embedded-graphics/hardware-bench/README.md

# Embedded graphics hardware test bench

Requires KiCAD 6.x.
