embedded-graphics/hardware-bench/3D/EPaper_2.13.step

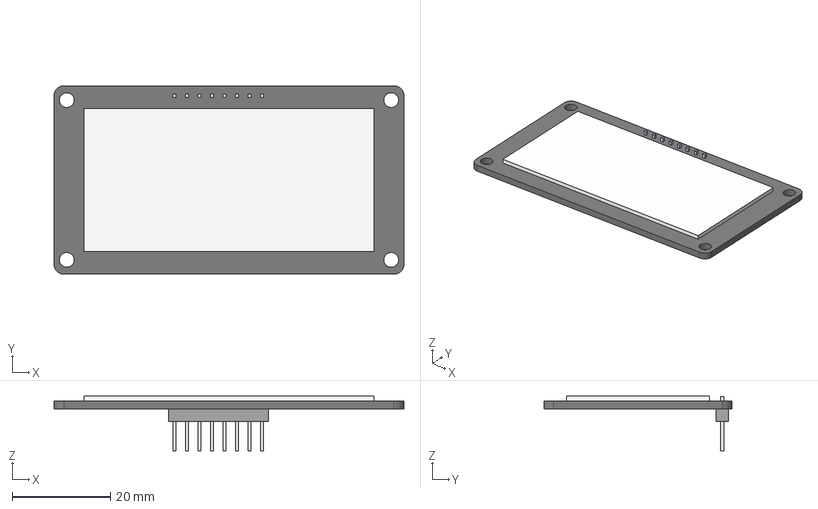
[picture p1: CAD file, 2022-11-12]
3D/EPaper_2.13.step
71.2 x 38.3 x 11.1 mm
PCB001
Pins001
EPD001
