embedded-graphics/hardware-bench/3D/OLED_0.91.step

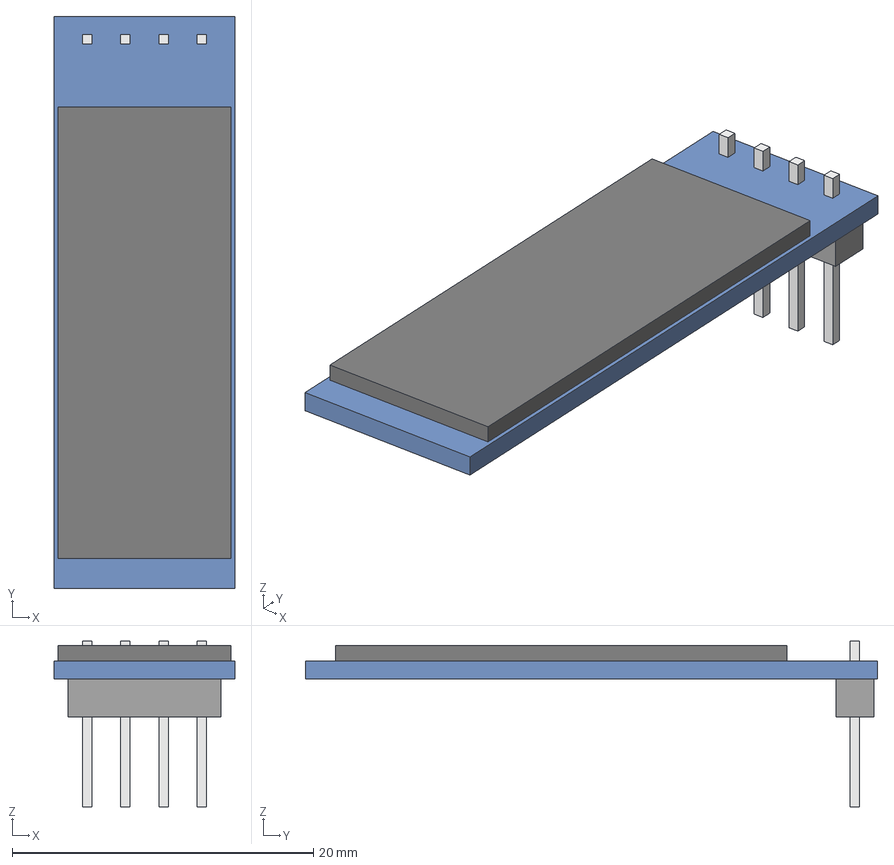
[picture p2: CAD file, 2022-11-12]
3D/OLED_0.91.step
12.0 x 38.0 x 11.0 mm
PCB
Pins
OLED
