embedded-graphics/hardware-bench/3D/RPi-Pico.step

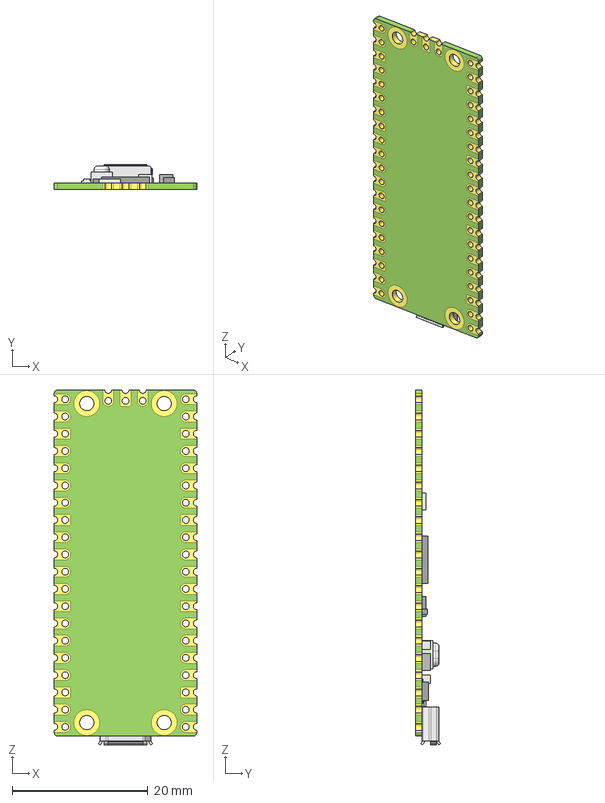
[picture p3: CAD file, 2022-11-12]
3D/RPi-Pico.step
21.0 x 3.73 x 52.3 mm
PICO_REF_BOARD.STEP
PICO_REF_USB.STEP
PICO_REF_SWITCH.STEP
PICO_REF_MICROCONTROLLER.STEP
PICO_REF_LED.STEP
PICO_REF_ONSEMI.STEP
PICO_BOURNS.STEP
PICO_MURATA.STEP x 2
PICO_RICHTEK.STEP
PICO_DIODES.STEP
PICO_AEL.STEP
PICO_WINBOND.STEP
