embedded-graphics/hardware-bench/3D/TFT_2.8_240x320.step

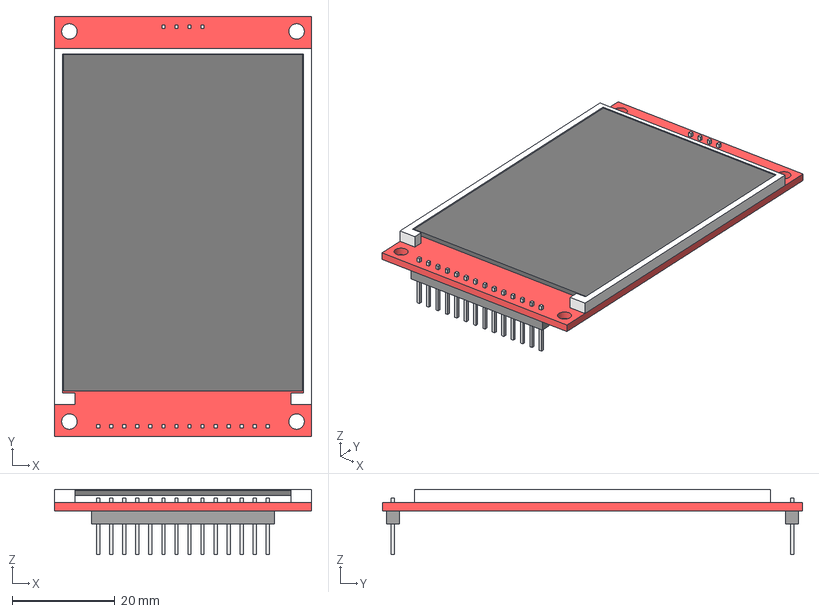
[picture p4: CAD file, 2022-11-12]
3D/TFT_2.8_240x320.step
50.0 x 81.7 x 12.7 mm
LCD
PCB
Pins Top
Pins Bottom
Frame
