embedded-graphics/hardware-bench/3D/GME12864-80.step

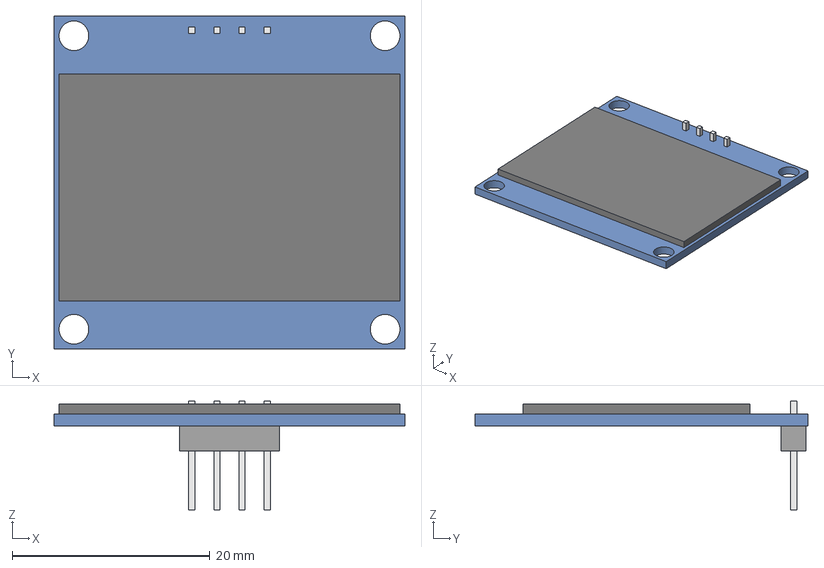
[picture p5: CAD file, 2022-11-12]
3D/GME12864-80.step
35.5 x 33.7 x 11.0 mm
OLED
PCB
Pins
