embedded-graphics/hardware-bench/3D/GME128128-02.step

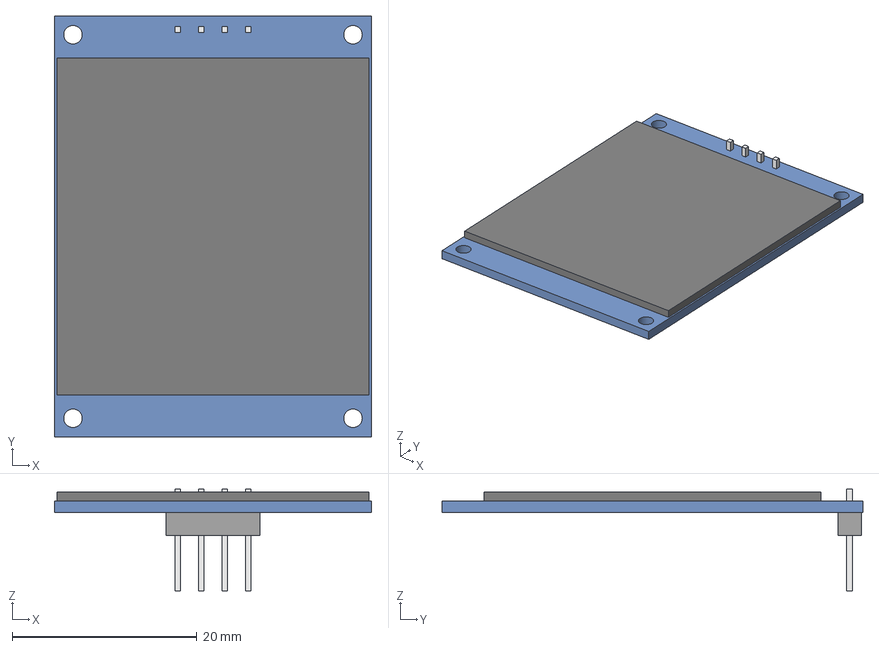
[picture p6: CAD file, 2022-11-12]
3D/GME128128-02.step
34.3 x 45.5 x 11.0 mm
OLED
PCB
Pins
