embedded-graphics/hardware-bench/(list of files, cad)

Other CAD files:
3D/EPaper_2.13.FCStd
3D/GME128128-02.FCStd
3D/GME12864-80.FCStd
3D/OLED_0.91.FCStd
3D/TFT_2.8_240x320.FCStd
