embedded-graphics/hardware-bench/hardware-bench.kicad_pcb

## KiCad design hardware-bench.kicad_pcb (2022-11-12)

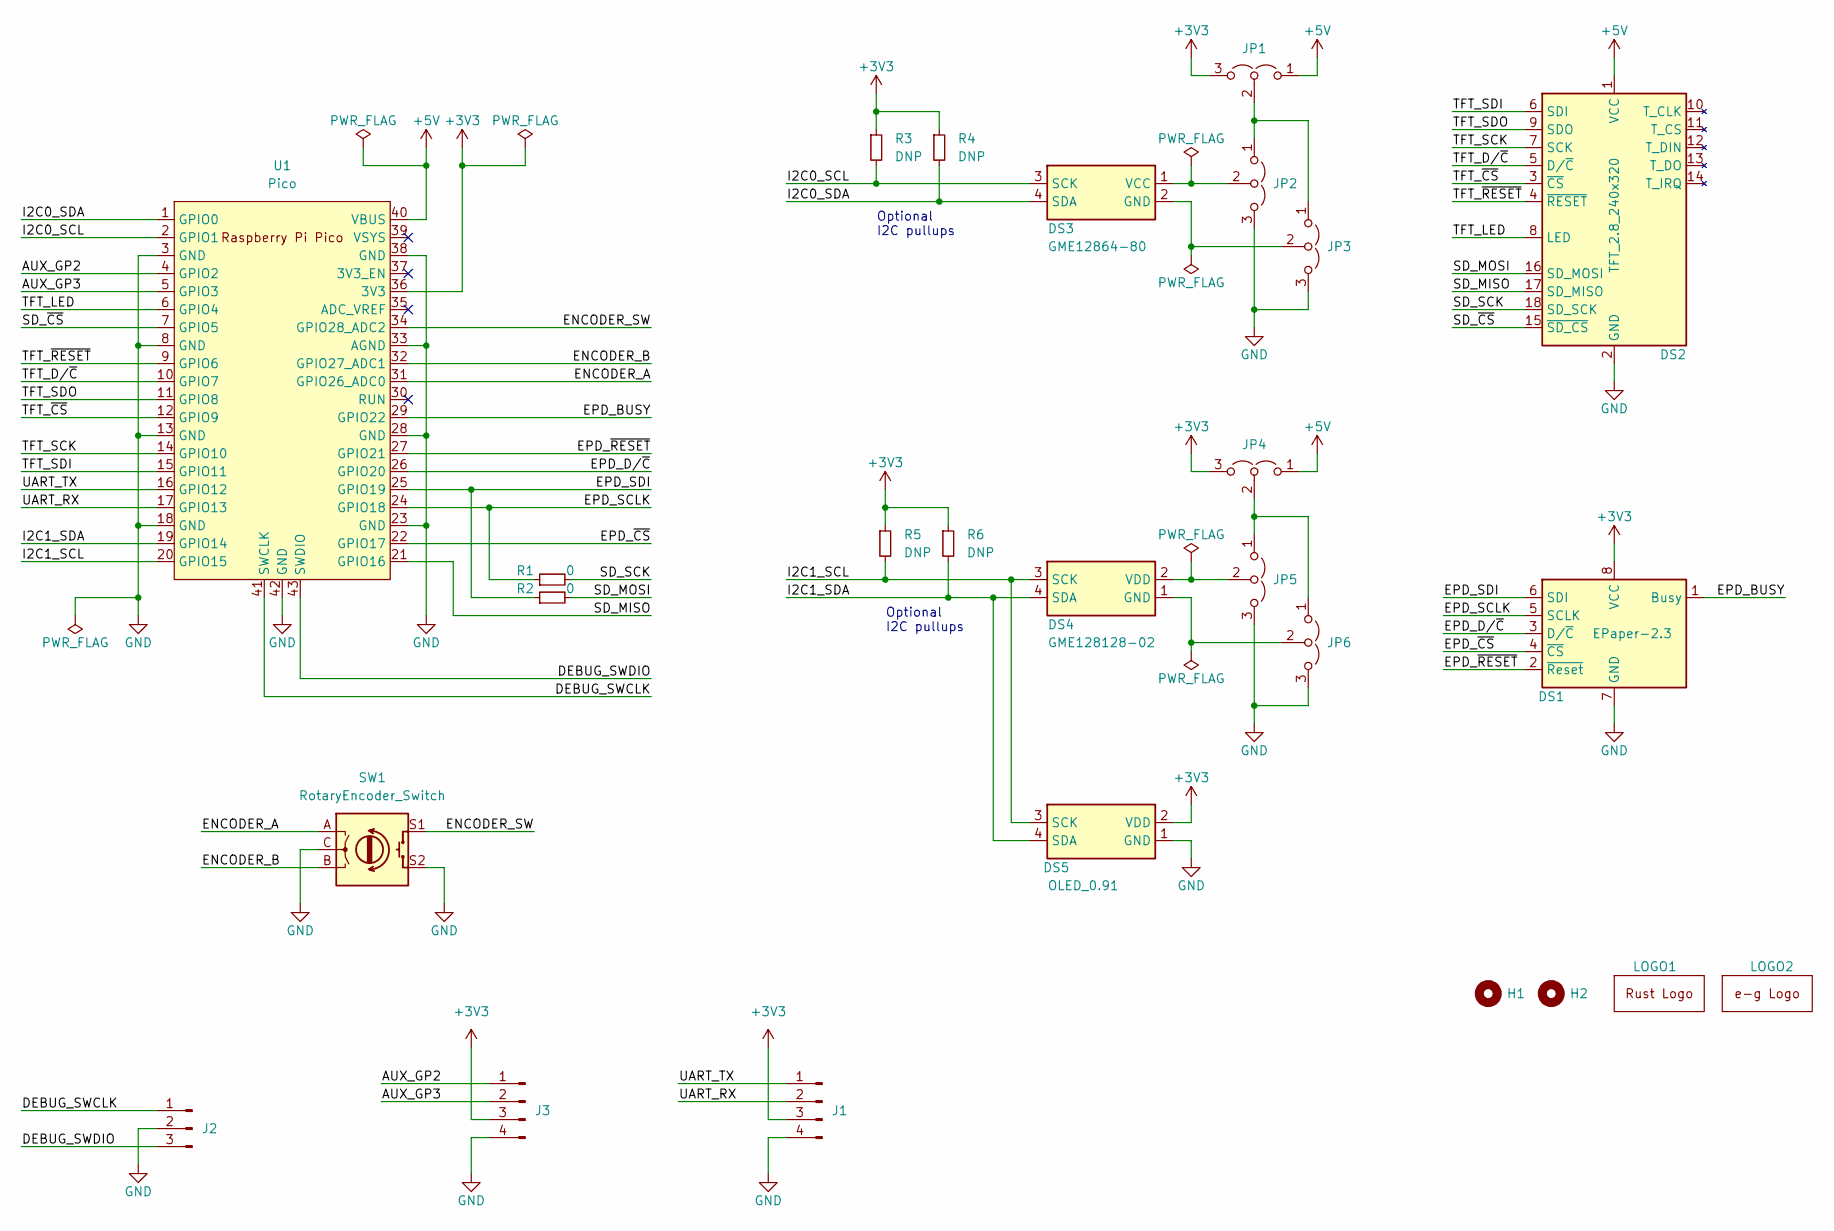
[picture p7: schematic hardware-bench.kicad_sch, Embedded-graphics hardware bench]

Parts:
DS1: EPaper-2.3; EPaper-2.13
DS2: TFT_2.8_240x320
DS3: GME12864-80
DS4: GME128128-02
DS5: OLED_0.91
H1, H2: MountingHole; MountingHole_3.2mm_M3
J1, J3: Conn_01x04_Male; PinHeader_1x04_P2.54mm_Horizontal_Flipped
J2: Conn_01x03_Male; PinHeader_1x03_P2.54mm_Horizontal_Flipped
JP1, JP2, JP3, JP4, JP5, JP6: Jumper_3_Open; PinHeader_1x03_P2.54mm_Vertical
LOGO1: Logo_Rust
LOGO2: Logo_E_G
R1, R2: 0; R_0603_1608Metric
R3, R4, R5, R6: DNP; R_0603_1608Metric
SW1: RotaryEncoder_Switch; RotaryEncoder_Alps_EC12E-Switch_Vertical_H20mm_CircularMoun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
U1: Pico; RPi_Pico_SMD

Connections:
+3V3: DS1.8 (VCC), DS5.2 (VDD), J1.3, J3.3, JP1.3 (B), JP4.3 (B), R3.1, R4.1, R5.1, R6.1, U1.36 (3V3)
+5V: DS2.1 (VCC), JP1.1 (A), JP4.1 (A), U1.40 (VBUS)
/AUX_GP2: J3.1, U1.4 (GPIO2)
/AUX_GP3: J3.2, U1.5 (GPIO3)
/DEBUG_SWCLK: J2.1, U1.41 (SWCLK)
/DEBUG_SWDIO: J2.3, U1.43 (SWDIO)
/ENCODER_A: SW1.A, U1.31 (GPIO26_ADC0)
/ENCODER_B: SW1.B, U1.32 (GPIO27_ADC1)
/ENCODER_SW: SW1.S1, U1.34 (GPIO28_ADC2)
/EPD_BUSY: DS1.1 (Busy), U1.29 (GPIO22)
/EPD_D/~C: DS1.3 (D/~C), U1.26 (GPIO20)
/EPD_SCLK: DS1.5 (SCLK), R1.1, U1.24 (GPIO18)
/EPD_SDI: DS1.6 (SDI), R2.1, U1.25 (GPIO19)
/EPD_~CS: DS1.4 (~CS), U1.22 (GPIO17)
/EPD_~RESET: DS1.2 (~Reset), U1.27 (GPIO21)
/I2C0_SCL: DS3.3 (SCK), R3.2, U1.2 (GPIO1)
/I2C0_SDA: DS3.4 (SDA), R4.2, U1.1 (GPIO0)
/I2C1_SCL: DS4.3 (SCK), DS5.3 (SCK), R5.2, U1.20 (GPIO15)
/I2C1_SDA: DS4.4 (SDA), DS5.4 (SDA), R6.2, U1.19 (GPIO14)
/SD_MISO: DS2.17 (SD_MISO), U1.21 (GPIO16)
/SD_MOSI: DS2.16 (SD_MOSI), R2.2
/SD_SCK: DS2.18 (SD_SCK), R1.2
/SD_~CS: DS2.15 (~SD_CS), U1.7 (GPIO5)
/TFT_D/~C: DS2.5 (D/~C), U1.10 (GPIO7)
/TFT_LED: DS2.8 (LED), U1.6 (GPIO4)
/TFT_SCK: DS2.7 (SCK), U1.14 (GPIO10)
/TFT_SDI: DS2.6 (SDI), U1.15 (GPIO11)
/TFT_SDO: DS2.9 (SDO), U1.11 (GPIO8)
/TFT_~CS: DS2.3 (~CS), U1.12 (GPIO9)
/TFT_~RESET: DS2.4 (~RESET), U1.9 (GPIO6)
/UART_RX: J1.2, U1.17 (GPIO13)
/UART_TX: J1.1, U1.16 (GPIO12)
GND: DS1.7 (GND), DS2.2 (GND), DS5.1 (GND), J1.4, J2.2, J3.4, JP2.3 (B), JP3.3 (B), JP5.3 (B), JP6.3 (B), SW1.C, SW1.S2, U1.3 (GND), U1.8 (GND), U1.13 (GND), U1.18 (GND), U1.23 (GND), U1.28 (GND), U1.33 (AGND), U1.38 (GND), U1.42 (GND)
unnamed: DS3.1 (VCC), JP2.2 (C)
unnamed: DS3.2 (GND), JP3.2 (C)
unnamed: DS4.1 (GND), JP6.2 (C)
unnamed: DS4.2 (VDD), JP5.2 (C)
unnamed: JP1.2 (C), JP2.1 (A), JP3.1 (A)
unnamed: JP4.2 (C), JP5.1 (A), JP6.1 (A)

Notes on the sheet:
Optional I2C pullups

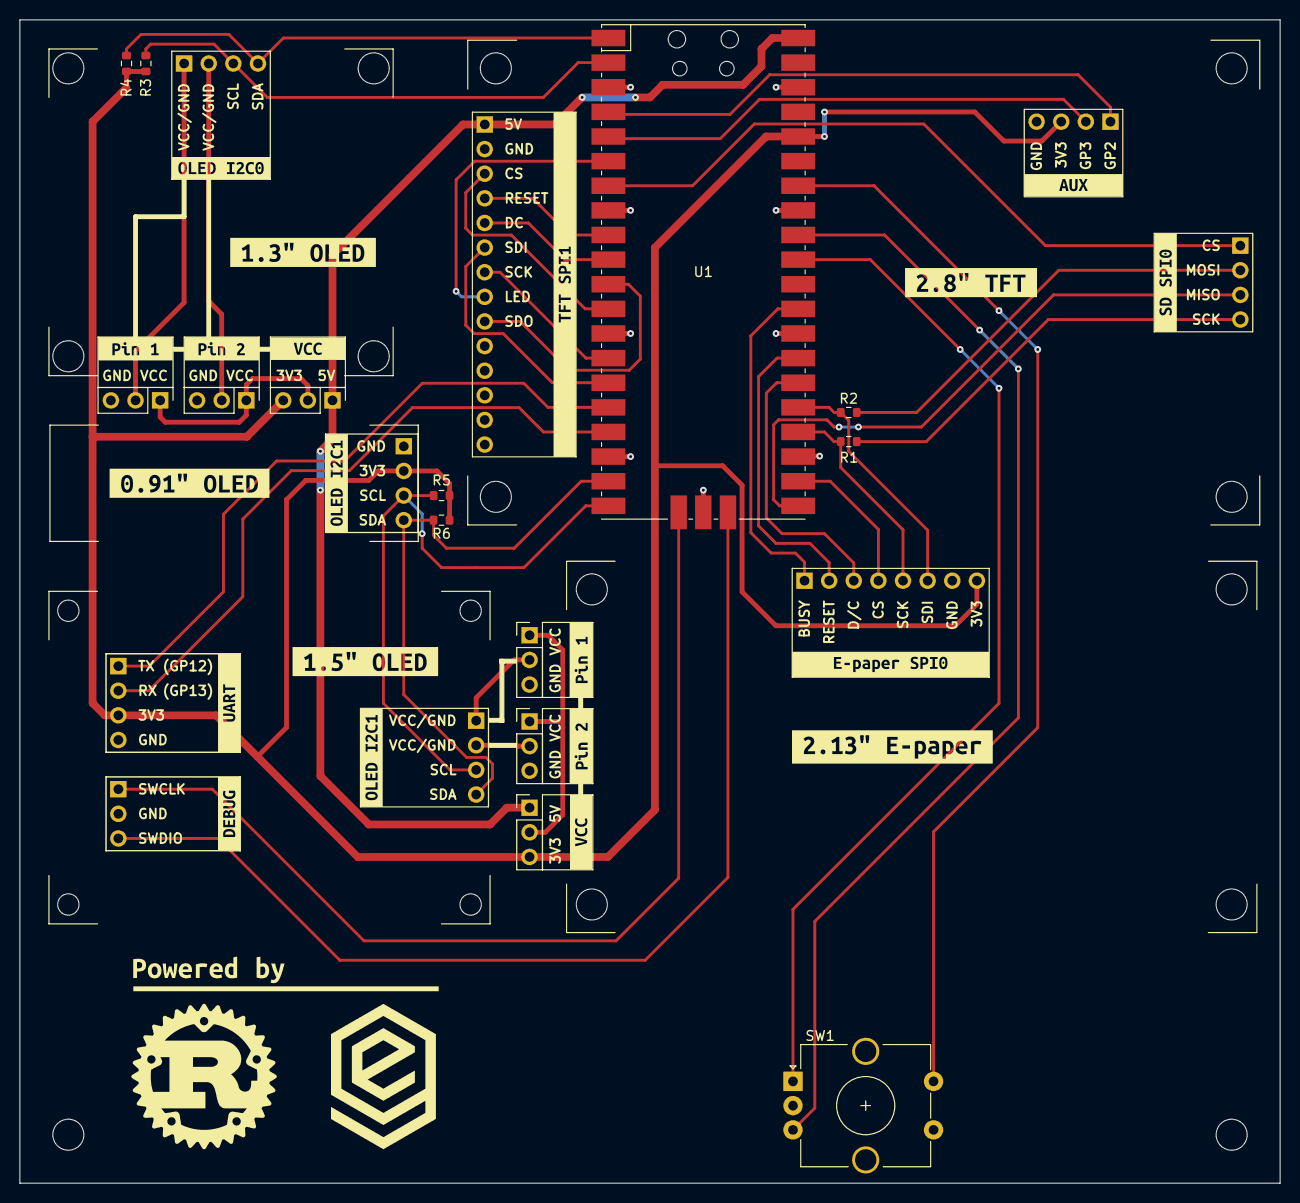
[picture p8: board hardware-bench.kicad_pcb from above]

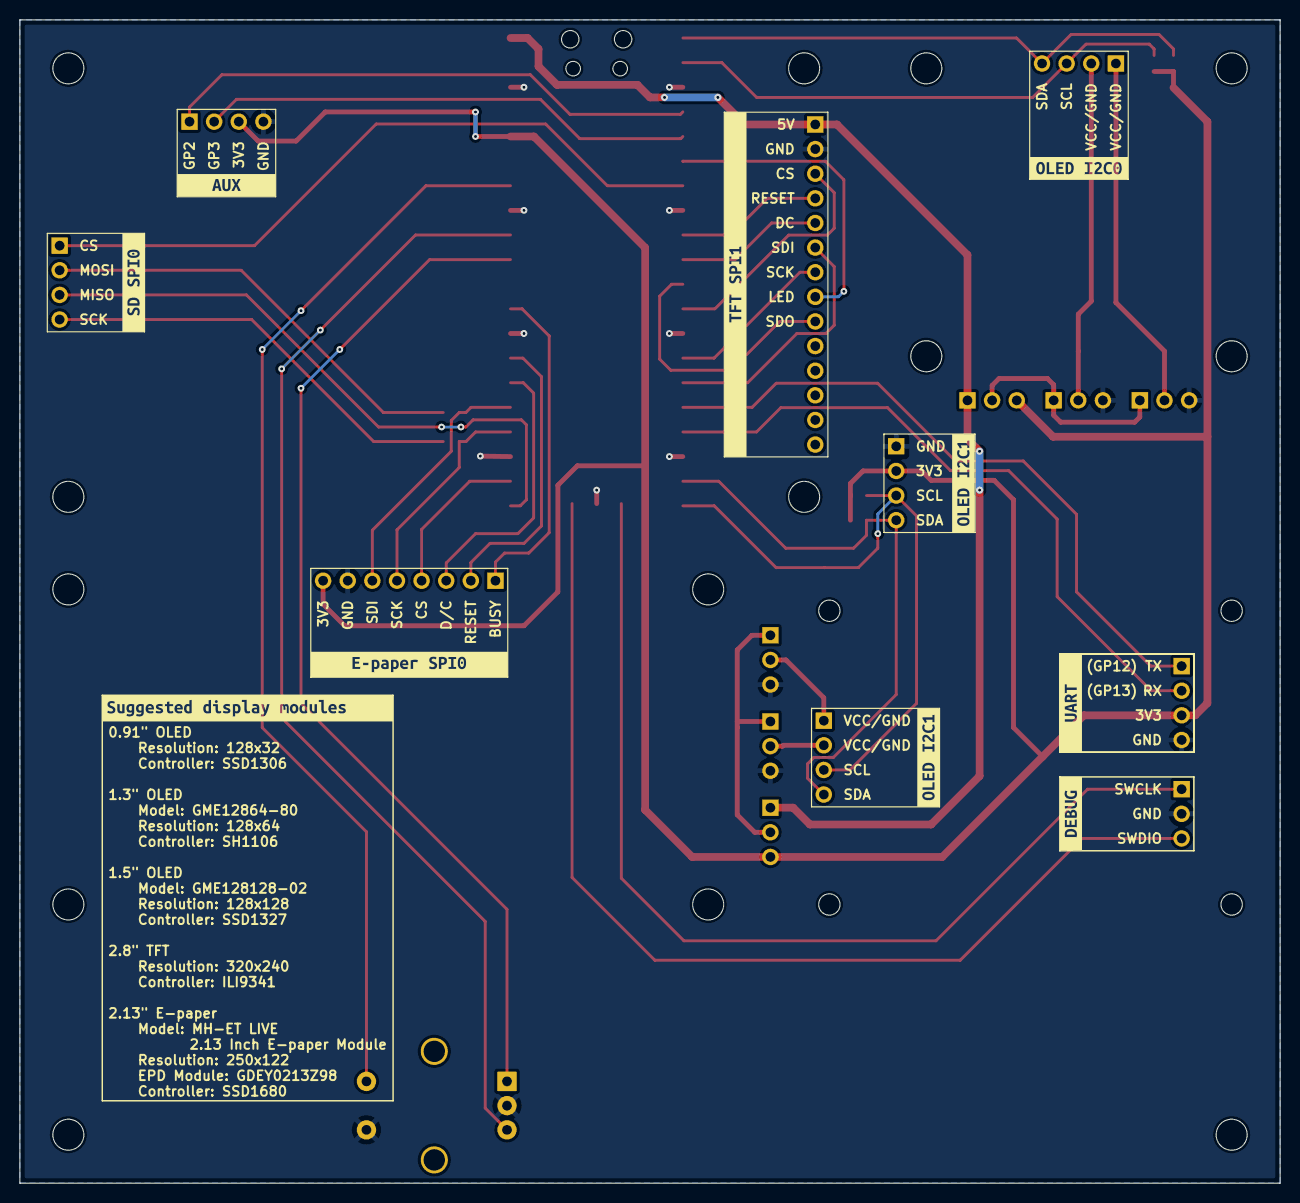
[picture p9: board hardware-bench.kicad_pcb from below]

Board: 2 copper layers, 130.0 x 120.0 mm, 57 parts (10 on the bottom side), 39 nets.

Other parts of the board:
kibuzzard-635BBA92: G***; kibuzzard-635BBA92
kibuzzard-636E8B55, kibuzzard-636E8B55#2: G***; kibuzzard-636E8B55
kibuzzard-636E8BC3, kibuzzard-636E8BC3#2: G***; kibuzzard-636E8BC3
kibuzzard-636E8C97, kibuzzard-636E8C97#2: G***; kibuzzard-636E8C97
kibuzzard-636E8D2A, kibuzzard-636E8D2A#2: G***; kibuzzard-636E8D2A
kibuzzard-636E8D77, kibuzzard-636E8D77#2: G***; kibuzzard-636E8D77
kibuzzard-636E8E76, kibuzzard-636E8E76#2: G***; kibuzzard-636E8E76
kibuzzard-636E8FDA, kibuzzard-636E8FDA#2: G***; kibuzzard-636E8FDA
kibuzzard-636E96FA: G***; kibuzzard-636E96FA
kibuzzard-636E891A, kibuzzard-636E891A#2, kibuzzard-636E891A#3, kibuzzard-636E891A#4: G***; kibuzzard-636E891A
kibuzzard-636E971C: G***; kibuzzard-636E971C
kibuzzard-636E9700: G***; kibuzzard-636E9700
kibuzzard-636E9707: G***; kibuzzard-636E9707
kibuzzard-636E9711: G***; kibuzzard-636E9711
kibuzzard-636E9726: G***; kibuzzard-636E9726
kibuzzard-636EACB9: G***; kibuzzard-636EACB9
kibuzzard-636EB72B: G***; kibuzzard-636EB72B
kibuzzard-636EB73F: G***; kibuzzard-636EB73F
kibuzzard-636EB715: G***; kibuzzard-636EB715
kibuzzard-636EB722: G***; kibuzzard-636EB722
kibuzzard-636EB734: G***; kibuzzard-636EB734
