embedded-graphics/hardware-bench/(commit log)

2022-04-20 Initial commit with SSD1306 and ILI9341
    [OLED-128x64-0.96.step, hardware-bench.kicad_pcb, hardware-bench.kicad_sch]
2022-11-12 Raspberry PI Pico hardware bench (#2)
    [EPaper_2.13.FCStd, EPaper_2.13.step, GME128128-02.FCStd, GME128128-02.step, GME12864-80.FCStd, GME12864-80.step, OLED-128x64-0.96.step, OLED_0.91.FCStd]
